fieldkit/darwin-weather-sensor/weather-sensor.brd

## EAGLE design weather-sensor.brd (2020-08-06)

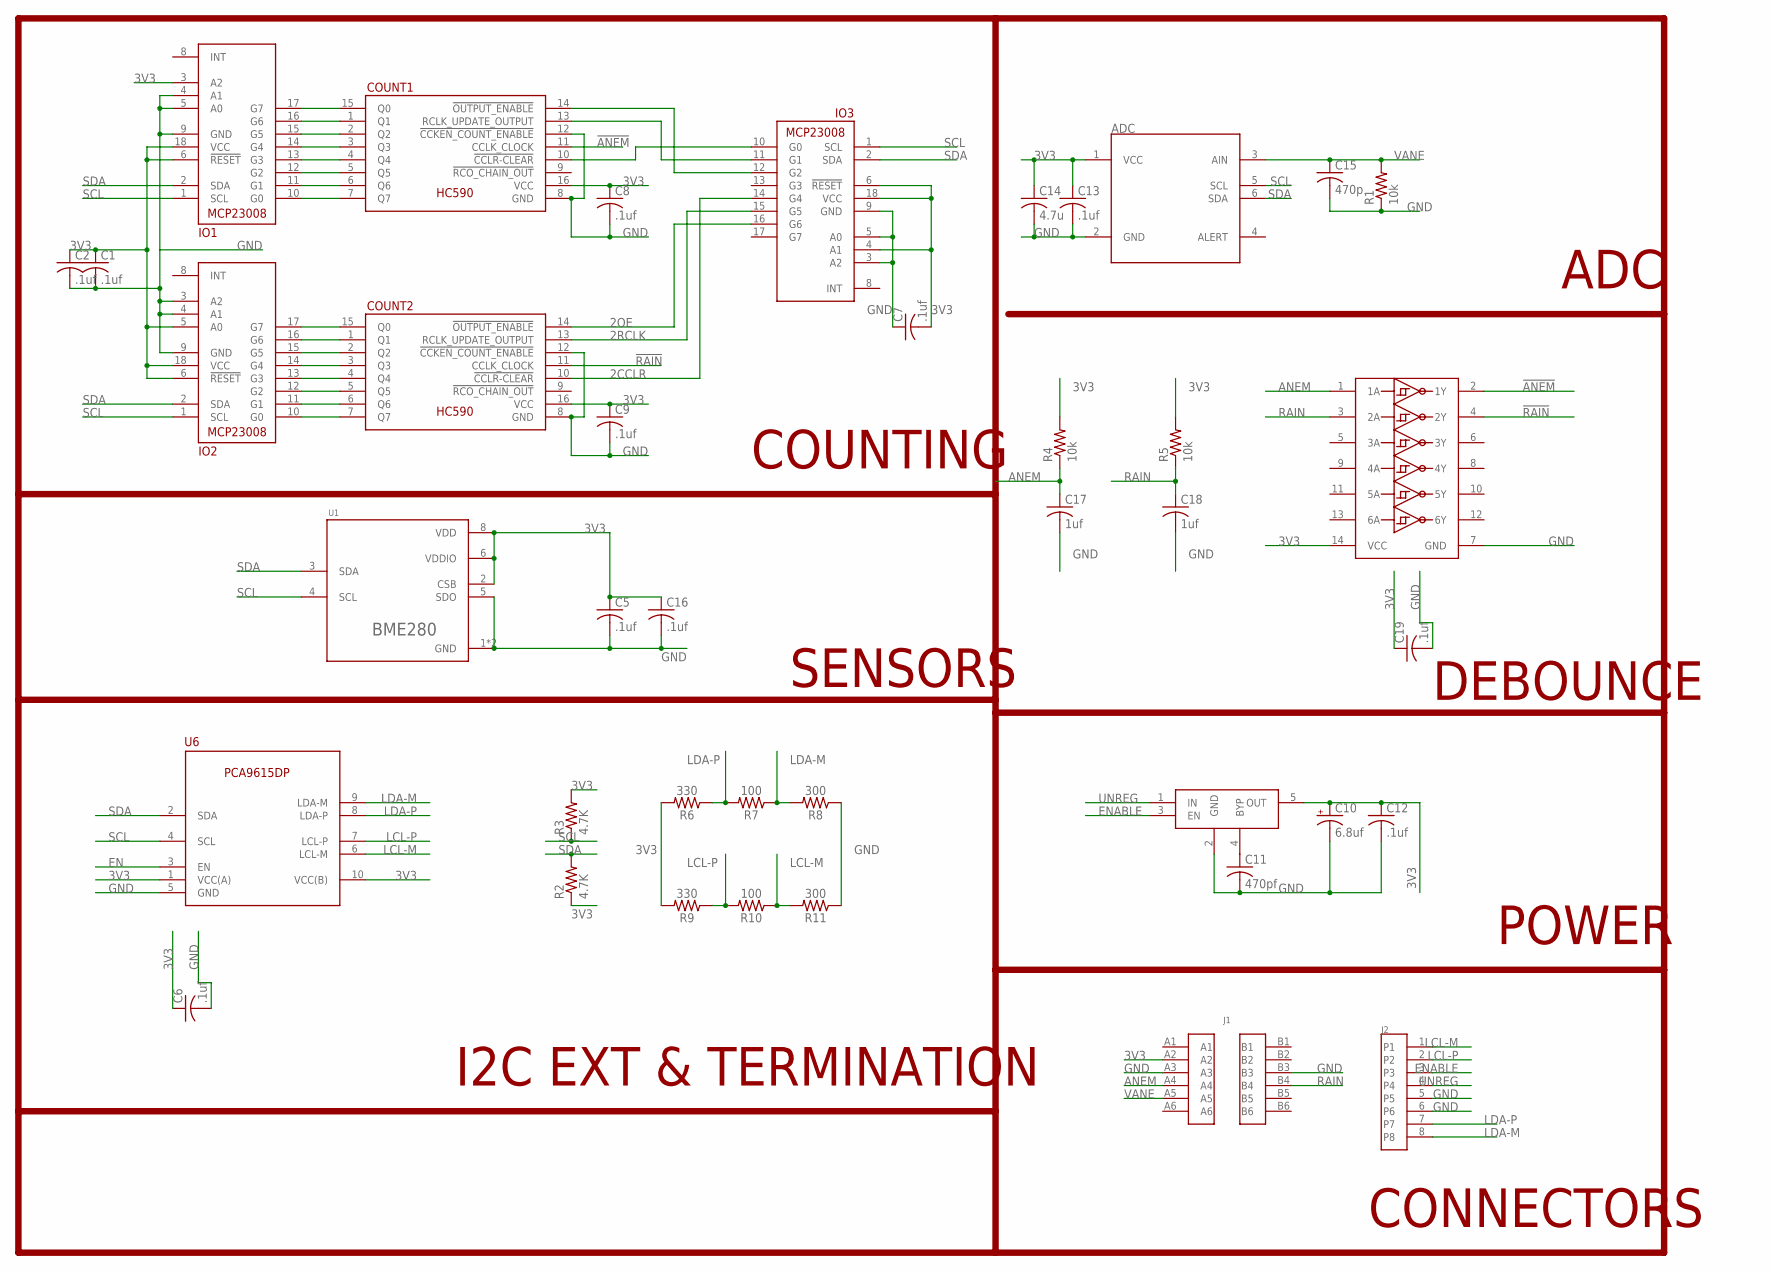
[picture p1: schematic weather-sensor.sch]

Parts:
ADC: ADC081C021SOT-DDC; SOP95P280X110-6
C1, C2, C5, C6, C7, C8, C9, C12, C13, C16, C19: .1uf; C0603K
C10: 6.8uf; A/3216-18R
C11: 470pf; C0603K
C14: 4.7u; C0603K
C15: 470p; C0603K
C17, C18: 1uf; C0603K
COUNT1, COUNT2: 74HC590; SOIC127P1050X265-16
INVERTER: 74HC14; SOIC127P780X200-14
IO1, IO2, IO3: MCP23008; SOIC18-W
J1: 43841-0005
J2: 95501-6889
R1, R4, R5: 10k; R0603
R2, R3: 4.7K; R0603
R6, R9: 330; 0603
R7, R10: 100; 0603
R8, R11: 300; 0603
U1: BME280; BM280
U5: MIC5219-3.3YM5-TR; SOT95P280X145-5
U6: PCA9615; SOP50P490X110-10

Connections:
2CCLR: COUNT2.10 (!CCLR-CLEAR), IO3.14 (G4)
2OE: COUNT2.14 (!OUTPUT_ENABLE), IO3.16 (G6)
2RCLK: COUNT2.13 (RCLK_UPDATE_OUTPUT), IO3.15 (G5)
3V3: ADC.1 (VCC), C1.1, C2.1, C5.1, C6.1, C7.2, C8.1, C9.1, C10.+, C12.1, C13.1, C14.1, C16.1, C19.1, COUNT1.16 (VCC), COUNT2.16 (VCC), INVERTER.14 (VCC), IO1.3 (A2), IO1.6 (!RESET), IO1.18 (VCC), IO2.5 (A0), IO2.6 (!RESET), IO2.18 (VCC), IO3.4 (A1), IO3.6 (!RESET), IO3.18 (VCC), J1.A2, R2.1, R3.2, R4.2, R5.2, R6.2, R9.2, U1.2 (CSB), U1.6 (VDDIO), U1.8 (VDD), U5.5 (OUT), U6.1 (VCC(A)), U6.10 (VCC(B))
!ANEM: COUNT1.11 (CCLK_CLOCK), INVERTER.2 (1Y)
!RAIN: COUNT2.11 (CCLK_CLOCK), INVERTER.4 (2Y)
ANEM: C17.1, INVERTER.1 (1A), J1.A4, R4.1
EN: U6.3 (EN)
ENABLE: J2.3, U5.3 (EN)
GND: ADC.2 (GND), C1.2, C2.2, C5.2, C6.2, C7.1, C8.2, C9.2, C10.-, C11.2, C12.2, C13.2, C14.2, C15.2, C16.2, C17.2, C18.2, C19.2, COUNT1.8 (GND), COUNT1.12 (!CCKEN_COUNT_ENABLE), COUNT2.8 (GND), COUNT2.12 (!CCKEN_COUNT_ENABLE), INVERTER.7 (GND), IO1.4 (A1), IO1.5 (A0), IO1.9 (GND), IO2.3 (A2), IO2.4 (A1), IO2.9 (GND), IO3.3 (A2), IO3.5 (A0), IO3.9 (GND), J1.A3, J1.B3, J2.5, J2.6, R1.1, R8.1, R11.1, U1.1 (GND), U1.5 (SDO), U1.7 (GND), U5.2 (GND), U6.5 (GND)
LCL-M: J2.1, R10.1, R11.2, U6.6 (LCL-M)
LCL-P: J2.2, R9.1, R10.2, U6.7 (LCL-P)
LDA-M: J2.8, R7.1, R8.2, U6.9 (LDA-M)
LDA-P: J2.7, R6.1, R7.2, U6.8 (LDA-P)
unnamed: COUNT2.15 (Q0), IO2.17 (G7)
unnamed: COUNT2.1 (Q1), IO2.16 (G6)
unnamed: COUNT2.2 (Q2), IO2.15 (G5)
unnamed: COUNT2.3 (Q3), IO2.14 (G4)
unnamed: COUNT2.4 (Q4), IO2.13 (G3)
unnamed: COUNT2.5 (Q5), IO2.12 (G2)
unnamed: COUNT2.6 (Q6), IO2.11 (G1)
unnamed: COUNT2.7 (Q7), IO2.10 (G0)
unnamed: COUNT1.15 (Q0), IO1.17 (G7)
unnamed: COUNT1.1 (Q1), IO1.16 (G6)
unnamed: COUNT1.2 (Q2), IO1.15 (G5)
unnamed: COUNT1.3 (Q3), IO1.14 (G4)
unnamed: COUNT1.4 (Q4), IO1.13 (G3)
unnamed: COUNT1.5 (Q5), IO1.12 (G2)
unnamed: COUNT1.6 (Q6), IO1.11 (G1)
unnamed: COUNT1.7 (Q7), IO1.10 (G0)
unnamed: COUNT1.14 (!OUTPUT_ENABLE), IO3.12 (G2)
unnamed: COUNT1.13 (RCLK_UPDATE_OUTPUT), IO3.11 (G1)
unnamed: COUNT1.10 (!CCLR-CLEAR), IO3.10 (G0)
unnamed: C11.1, U5.4 (BYP)
RAIN: C18.1, INVERTER.3 (2A), J1.B4, R5.1
SCL: ADC.5 (SCL), IO1.1 (SCL), IO2.1 (SCL), IO3.1 (SCL), R3.1, U1.4 (SCL), U6.4 (SCL)
SDA: ADC.6 (SDA), IO1.2 (SDA), IO2.2 (SDA), IO3.2 (SDA), R2.2, U1.3 (SDA), U6.2 (SDA)
UNREG: J2.4, U5.1 (IN)
VANE: ADC.3 (AIN), C15.1, J1.A5, R1.2

Notes on the sheet:
COUNTING
ADC
DEBOUNCE
POWER
CONNECTORS
I2C EXT & TERMINATION
SENSORS

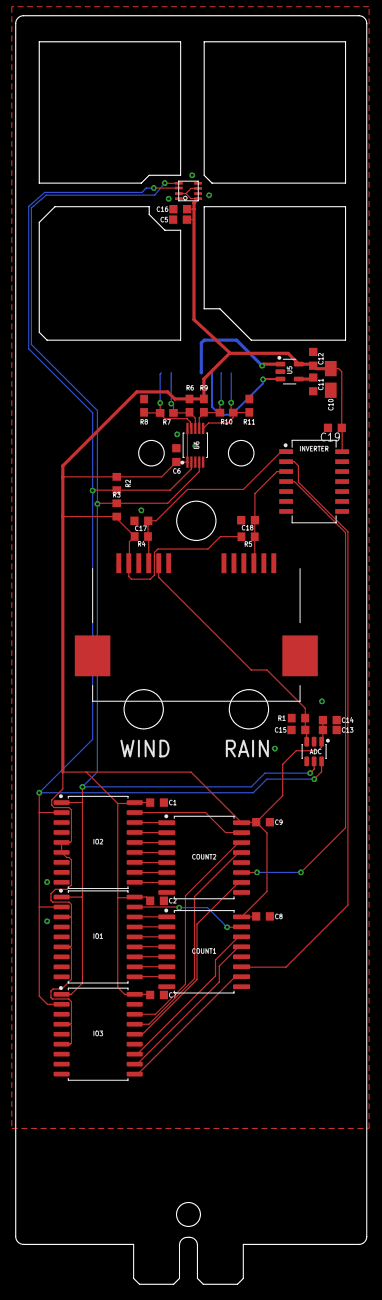
[picture p2: board weather-sensor.brd from above]

Board: 2 copper layers, 44.7 x 161.5 mm, 40 parts (1 on the bottom side), 38 nets.
