fieldkit/darwin-weather-sensor/(commit log)

2019-07-17 Test Article 1
    [weather-sensor.brd, weather-sensor.sch]
2019-09-04 Changed range extender and added debounce to switched inputs.
    [weather-sensor.brd, weather-sensor.sch]
2019-10-17 Changed power architecture for module/sesnor power synchronization. TA4.
    [weather-sensor-panel.brd, weather-sensor.brd, weather-sensor.sch]
2020-02-11 New Panel
    [4-up.brd, 4-up.sch, weather-sensor.brd]
2020-08-06 Replaced sensors with BME280, Reworked outline for compatibility with new arm.
    [weather-sensor.brd, weather-sensor.sch]
2020-10-23 Cleaned up deprecated files.
    [4-up.brd, 4-up.sch, weather-sensor-panel.brd]
